q287950091/Self_Learning_Induction_Heater/Picture/IMG_0487.jpg

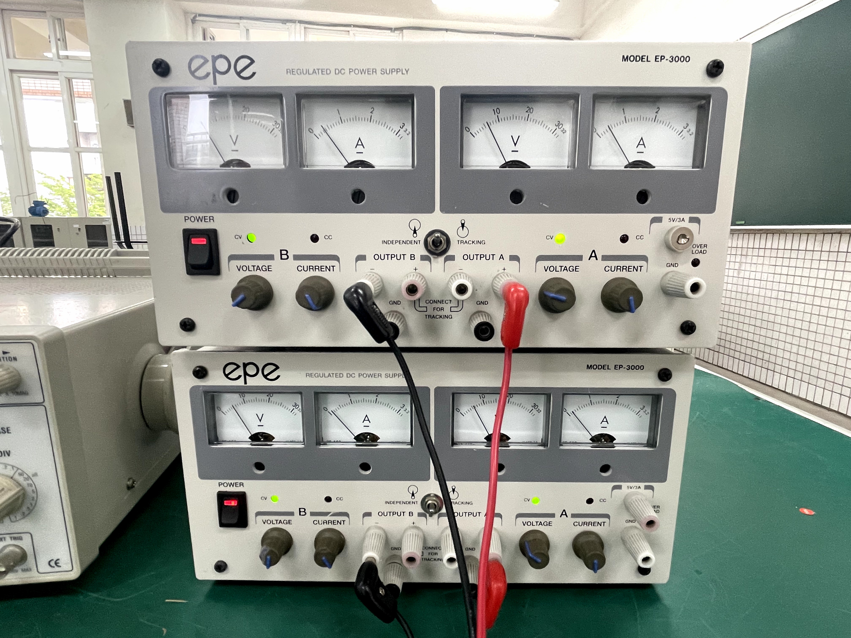
Picture/IMG_0487.jpg
