q287950091/Self_Learning_Induction_Heater/Picture/IMG_20221126_150517.jpg

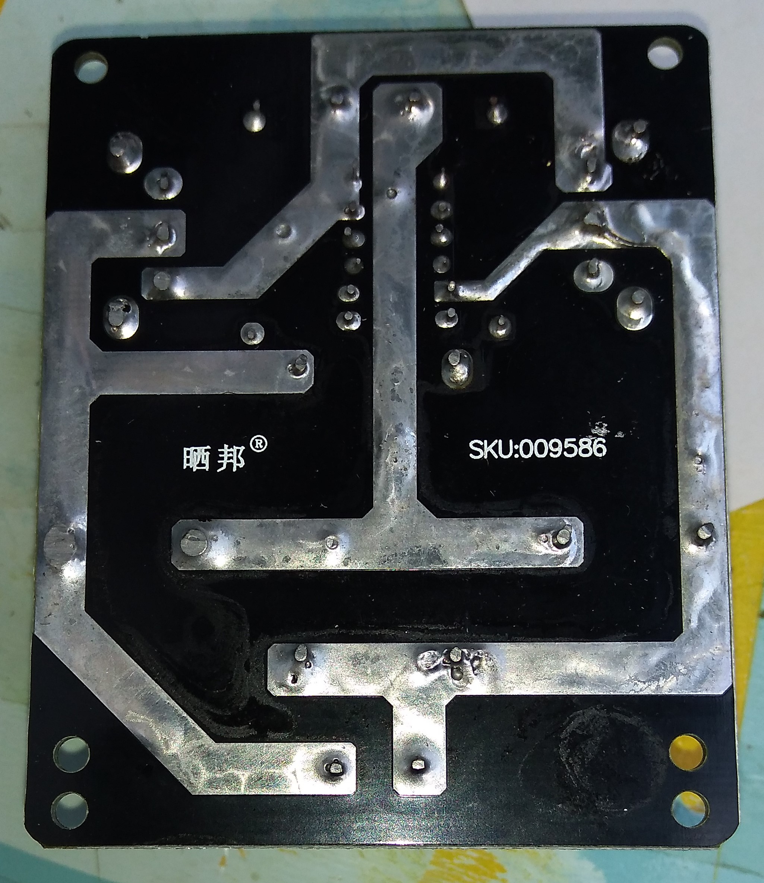
Picture/IMG_20221126_150517.jpg
