q287950091/Self_Learning_Induction_Heater/Picture/IMG_0478.jpg

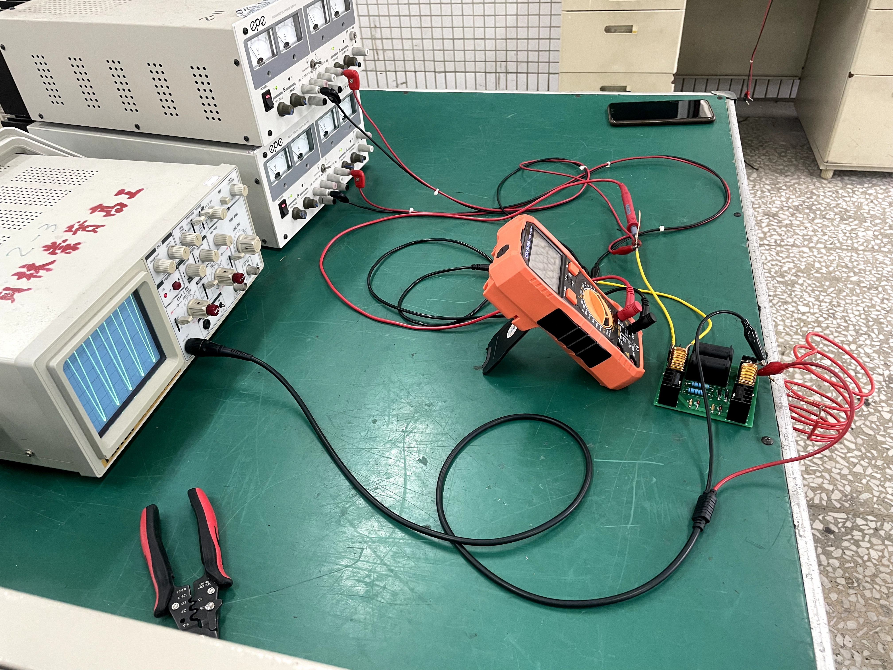
Picture/IMG_0478.jpg
