q287950091/Self_Learning_Induction_Heater/Picture/IMG_0480.jpg

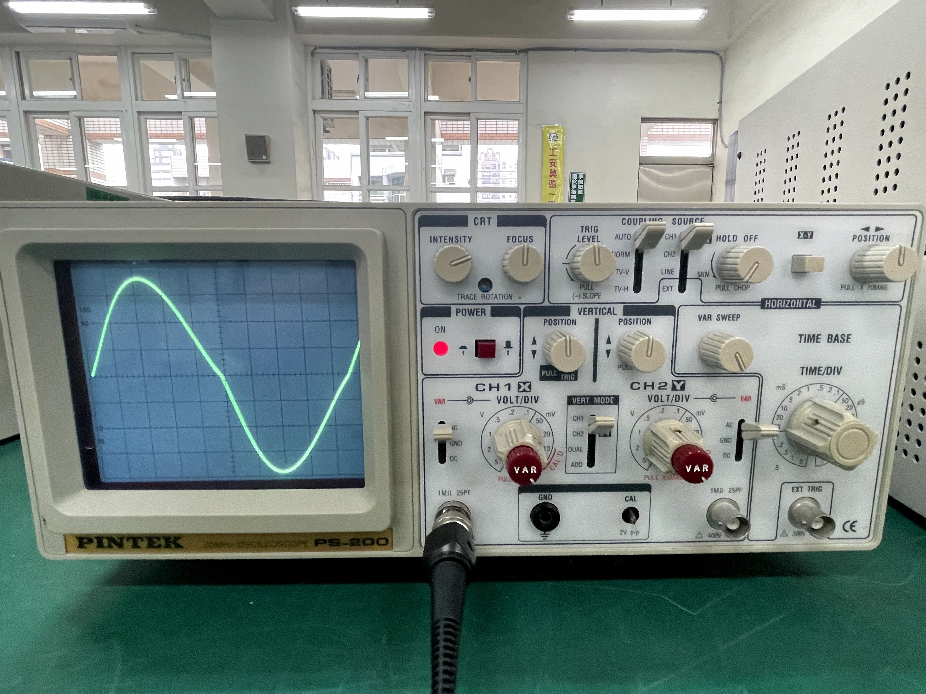
Picture/IMG_0480.jpg
