q287950091/Self_Learning_Induction_Heater/Picture/IMG_0481.jpg

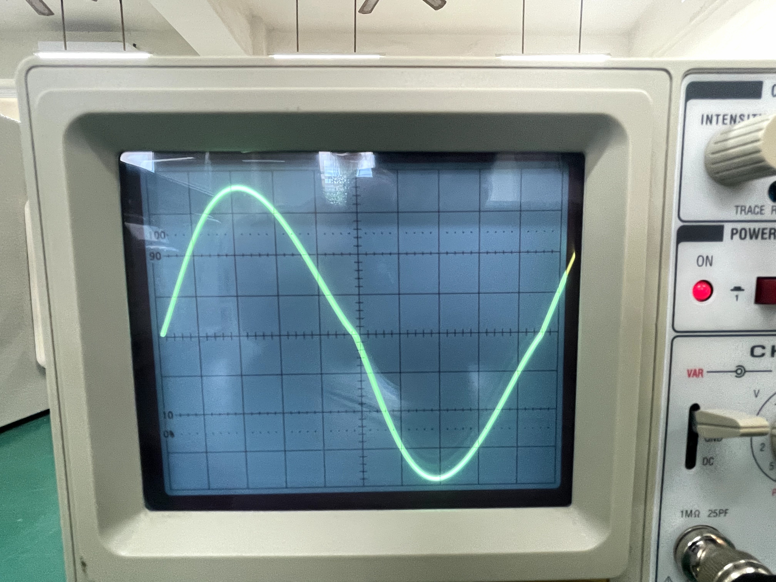
Picture/IMG_0481.jpg
