q287950091/Self_Learning_Induction_Heater/Picture/IMG_0483.jpg

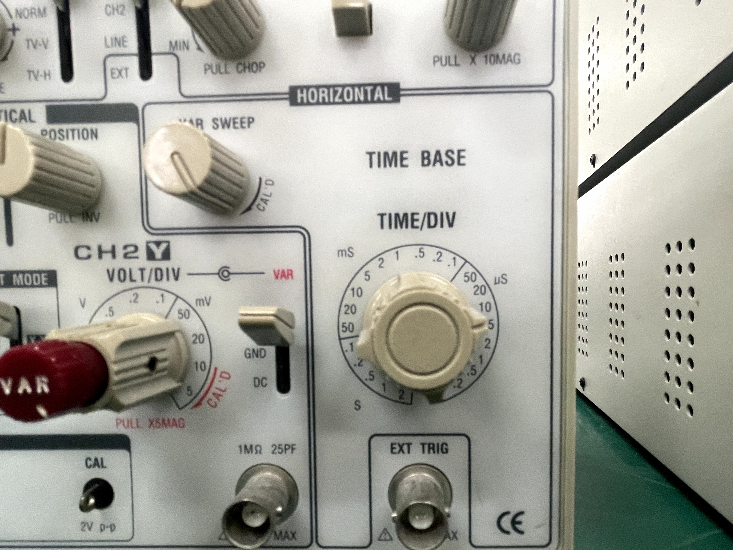
Picture/IMG_0483.jpg
