q287950091/Self_Learning_Induction_Heater/Picture/IMG_9511.jpg

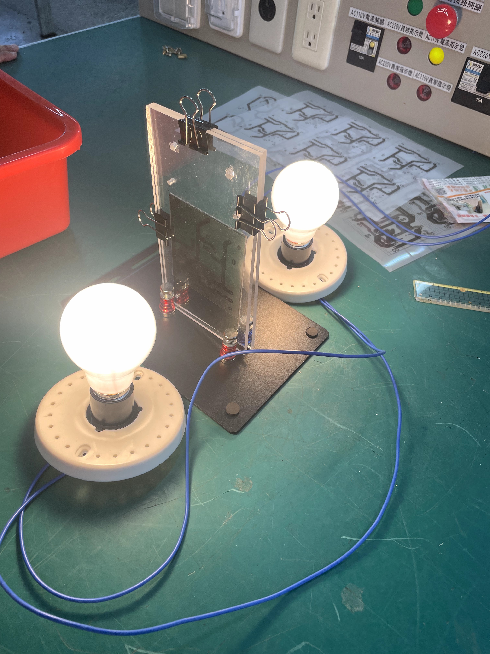
Picture/IMG_9511.jpg
