q287950091/Self_Learning_Induction_Heater/Picture/IMG_9516.jpg

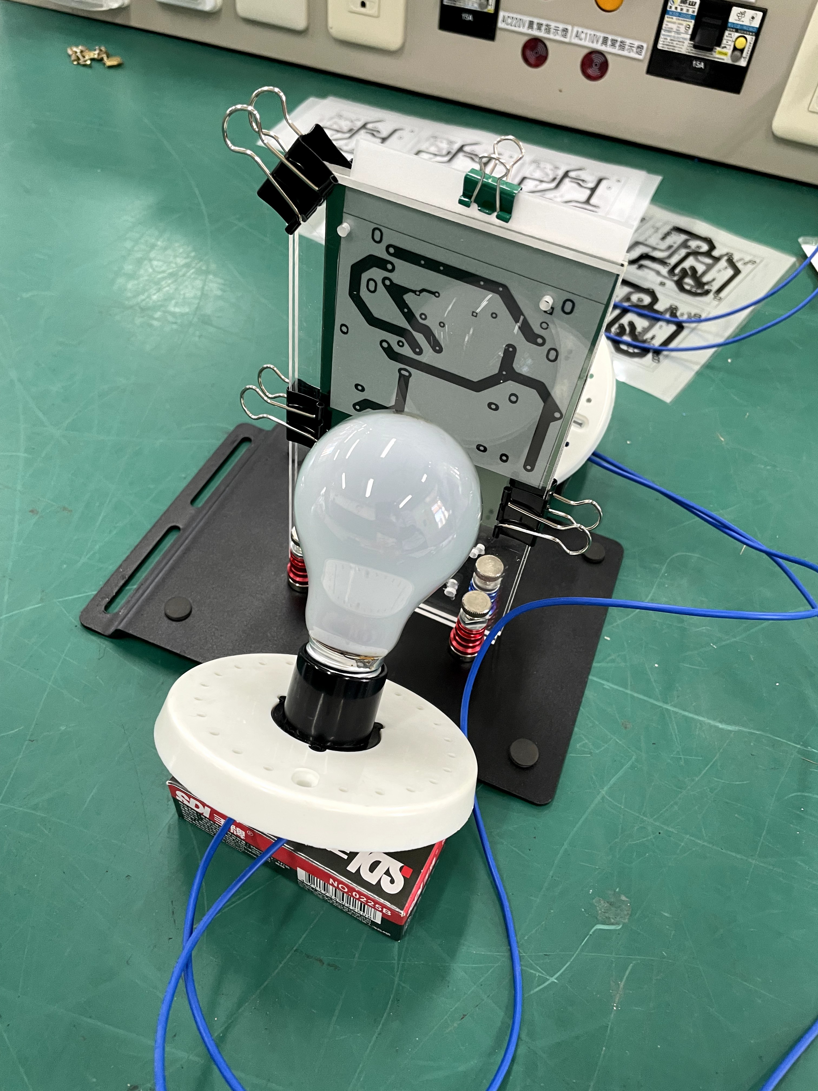
Picture/IMG_9516.jpg
