q287950091/Self_Learning_Induction_Heater/Picture/IMG_9517.jpg

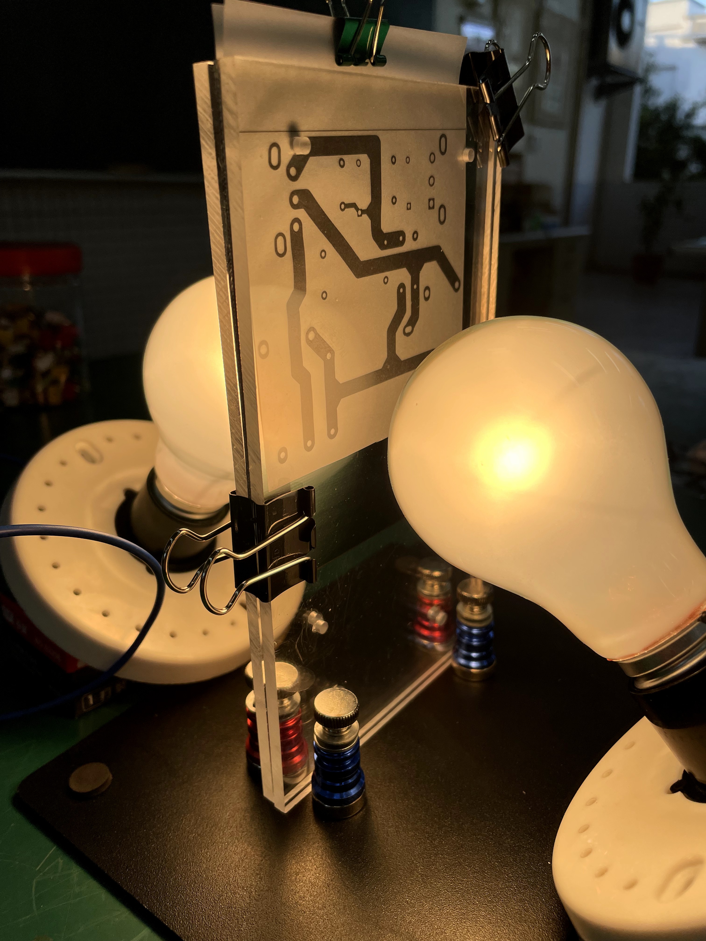
Picture/IMG_9517.jpg
