q287950091/Self_Learning_Induction_Heater/Picture/IMG_20230408_212003.jpg

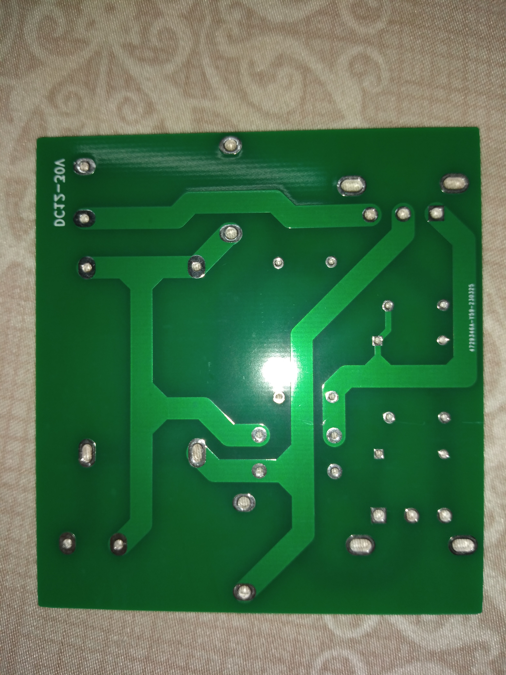
Picture/IMG_20230408_212003.jpg
