q287950091/Self_Learning_Induction_Heater/Picture/IMG_20230506_221551.jpg

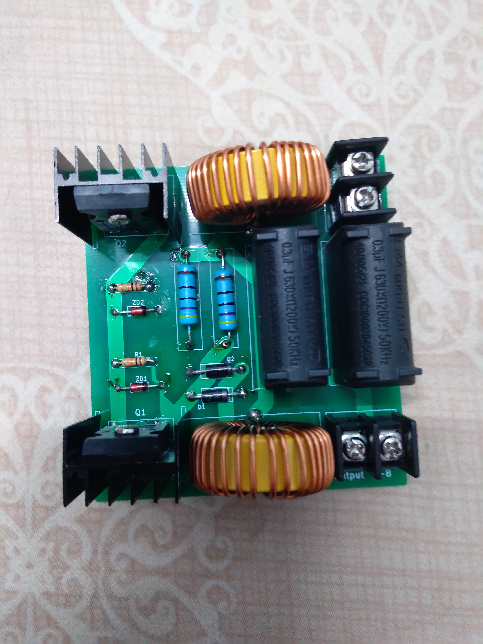
Picture/IMG_20230506_221551.jpg
