q287950091/Self_Learning_Induction_Heater/KiCAD/P.kicad_pcb

## KiCad design KiCAD/P.kicad_pcb (2023-05-06)

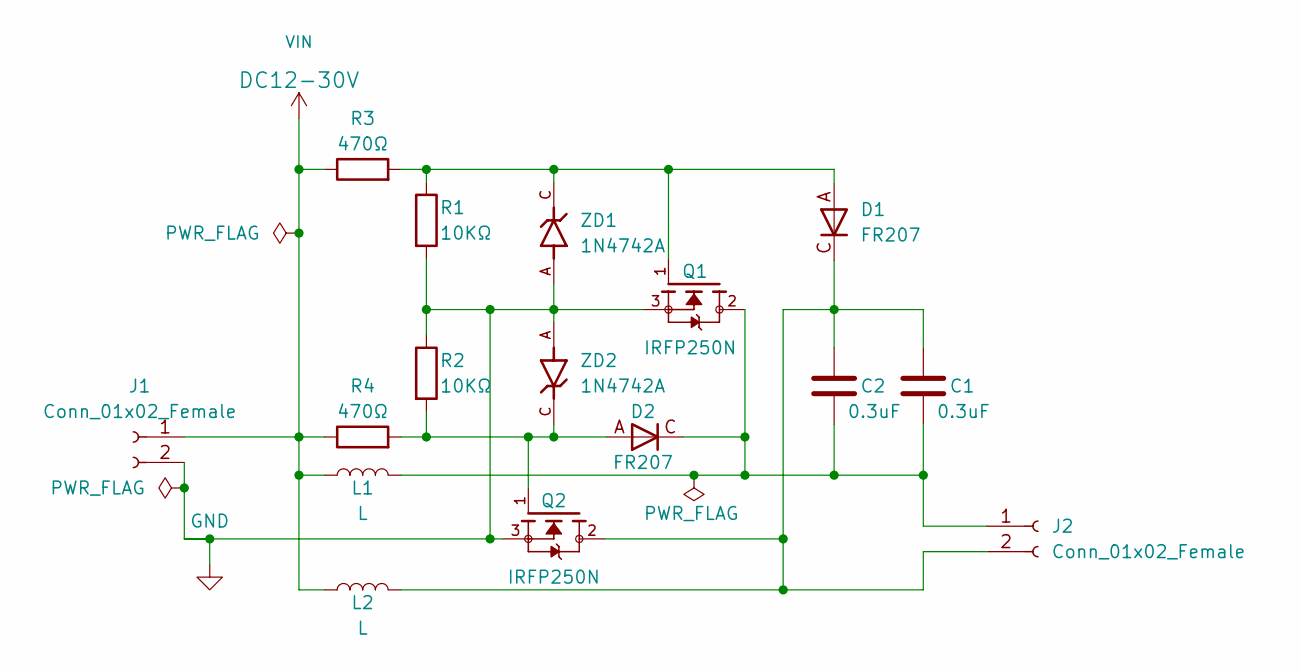
[picture p26: schematic P.kicad_sch]

Parts:
C1, C2: 0.3uF; MKPH_SH_0.3uF
D1, D2: FR207; DO15-12
J1, J2: Conn_01x02_Female; x2_Hub
L1, L2: L; Inductor_0.1mH
Q1, Q2: IRFP250N; TO545P1590X530X2460-3
R1, R2: 10KΩ; 1-4W_Resistor
R3, R4: 470Ω; 1W_Resistor
ZD1, ZD2: 1N4742A; DIOAD1060W70L435D230; PARTREV F1606

Connections:
GND: J1.2, Q1.3, Q2.3, R1.2, R2.1, ZD1.A, ZD2.A
unnamed: C1.1, C2.1, D1.C, J2.2, L2.2, Q2.2
unnamed: C1.2, C2.2, D2.C, J2.1, L1.2, Q1.2
unnamed: D1.A, Q1.1, R1.1, R3.2, ZD1.C
unnamed: D2.A, Q2.1, R2.2, R4.2, ZD2.C
VIN: J1.1, L1.1, L2.1, R3.1, R4.1

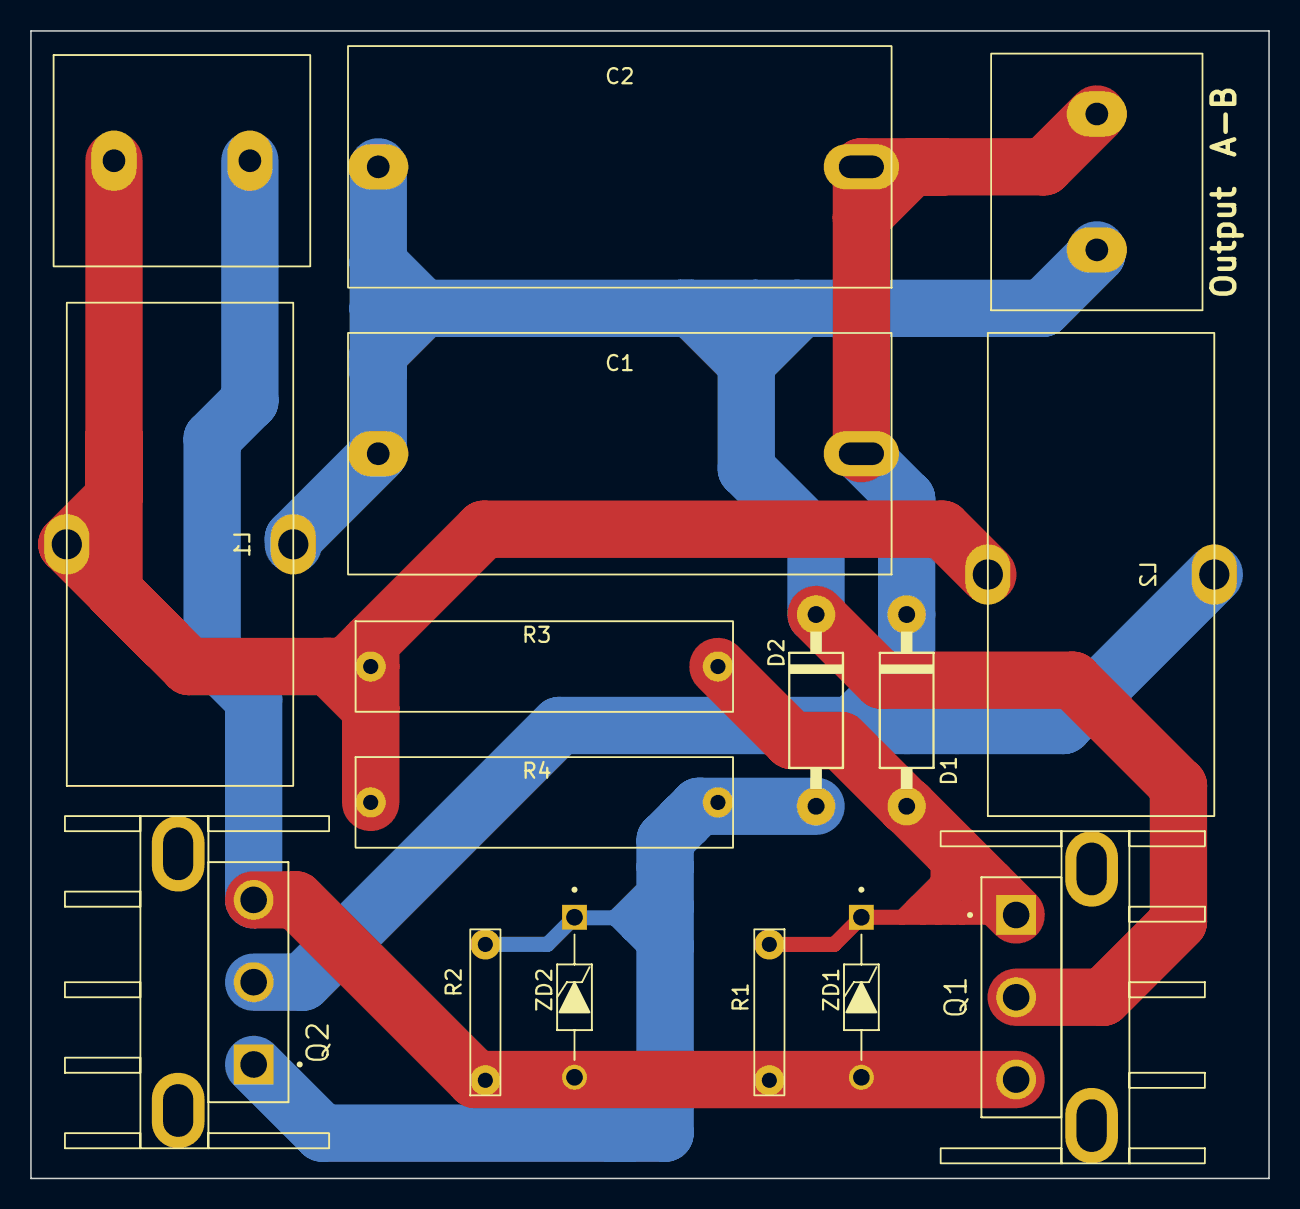
[picture p27: board P.kicad_pcb from above]

Board: 2 copper layers, 82.0 x 76.0 mm, 16 parts (0 on the bottom side), 6 nets.
